schorsch3000/TrustIssue/README.md

# Trust Issue

A hardware TOTP vault for people who don't trust their computers.

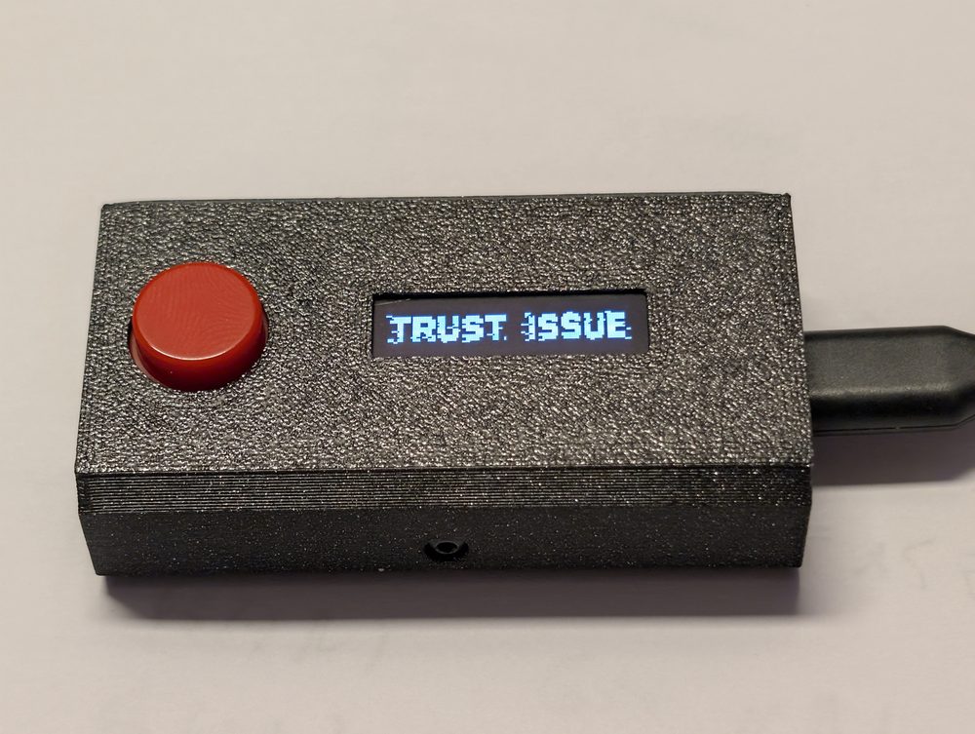
[picture p1: docs/_static/device/device-readme.jpg]
The finished device: a 3D printed case with a red button and the display, on a USB cable


The secrets live on a small device (an Arduino Nano with a 128x32 OLED and one button) and never
leave it. The host can add keys, list their names, and ask for a code, but every one of those
needs somebody to hold the button on the device while its display shows what is being done.
Malware on the laptop can neither export the secrets nor silently use them, and it cannot reflash
the device either: the bootloader only opens after a gesture on the button.

`wiring.md` shows how to wire the Nano, the display and the button; the 3D printed case is described in the documentation (`docs/hardware/case.md`, files in `Case/`).

`CLAUDE.md` holds the design decisions and the detailed state of the project.

## Why not a YubiKey?

If a service supports FIDO2/WebAuthn, use a YubiKey (or any security key) there: it is phishing-resistant, which a
TOTP code never is, and it is better engineered than this project. Trust Issue is for the many services that only
offer TOTP, and it differs from a YubiKey's OATH feature in a few ways:

- **You see what you approve.** The display shows the key name and the local date and time of the code, and a code
  needs a deliberate 1 to 2 second hold. A YubiKey has no display: the host decides which credential and which time
  to ask for, and a touch is a context-free tap that malware can time. Without a touch requirement set per
  credential, a compromised host can read codes without any gesture.
- **Open and auditable.** The firmware, the bootloader and the host tool are all here and under the GPL. Updates need
  a physical gesture and can be protected with a PIN; a YubiKey's firmware cannot be updated or inspected by its owner.
- **Cheap and replaceable.** An Arduino Nano and a small display cost a fraction of a YubiKey, and keys are not bound
  to a vendor's app (the host side is a small command line tool and menus).
- **What you give up.** A YubiKey is a certified secure element that resists physical attacks; an ATmega328P does not
  (see "Physical access" below). It also only does TOTP: no FIDO2, no smartcard or PGP functions. It holds fewer
  keys than a YubiKey 5's OATH application (20 here, 32 there, 64 on newer firmware). And it is a do-it-yourself build.

Both can be used together; they solve different parts of the problem.

## What is in here

| Path | What |
| --- | --- |
| `firmware/core` | the application: serial protocol, confirm screens, idle logo, autonomous wipe |
| `firmware/trustcore` | portable C++ core (SHA-1, HMAC, TOTP, Base32, EEPROM storage, protocol parser, time) with host tests in `firmware/test` |
| `firmware/bootloader`  | the button-gated bootloader (2 KB, from scratch) |
| `firmware/calibration` | tiny firmware to try out contrast, logo and font on the display |
| `firmware/rigisp` | the test rig: ArduinoISP plus a button finger, on a second Nano (see `tools/build/rig.py`) |
| `trustctl` | the host tool in Go: `list`, `token`, `add`, `del`, `tz`, `config`, `wipe`, `flash`, `calibrate`, `font extract`, `logo extract`, `daemon` |
| `trustctl/cmd/trustctl-import` | `trustctl-import`: imports a Google Authenticator export with a webcam (a local web page, see below) |
| `tools/user` | tools for people who use the device: `trustctl-menu`, `dummy-keys.html` (fake keys), `font2png.py`, `png2font.py`, `c64rom2font.py`, `final_lock.sh`, `onboard_usbtiny.sh` |
| `tools/build` | for building and testing the project: end-to-end tests (need the rig), `release.sh`, `embed_firmware.sh`, `embed_fonts.py`, `gen_params.py`, `flash.py` |

## Hardware

Arduino Nano (ATmega328P, 16 MHz), SSD1306 128x32 OLED on I2C (A4 SDA, A5 SCL, address 0x3C), a
push button from A3 to GND (A3 to A5, 5V and GND are all on the analog side of the Nano). For development a second Arduino (an Uno) acts as ISP programmer and as
the "finger": its D4 goes through 1 kOhm to the Nano's A3, its D10 to the Nano's RST, and D11 to D13
to the Nano's D11 to D13 (full table in `CLAUDE.md`).

## Setting up a device

1. **With a USBtinyISP programmer** one script does steps 1 and 3 at once: `tools/user/onboard_usbtiny.sh --yes` (chip erase, bootloader, the core firmware built into the repo, fuses, development lock bits; `--final-lock` for a finished device). Otherwise:
1. **Bootloader (once, over ISP).** Put the `ArduinoISP` example sketch on the Uno, then
   `tools/user/flash_bootloader.sh <uno port> --yes`. It builds the bootloader, sets the fuses and the
   development lock bits and verifies them. The burn starts with a chip erase, so the keys are gone, unless you add
   `--keep-eeprom`. `tools/user/unlock.sh <uno port> --yes` is the way back from the final lock bits
   (`final_lock.sh`): a chip erase that destroys flash and EEPROM, followed by `flash_bootloader.sh`.
1. **Host tool.** Download the archive for your system from the
   [releases](https://github.com/schorsch3000/TrustIssue/releases) (it holds `trustctl`, `trustctl-import` and the tools from `tools/user`; the
   `nightly` prerelease is the latest commit), or build it: `cd trustctl && go build -o bin/trustctl ./cmd/trustctl` (a static binary; Go 1.25+, which
   the module fetches by itself).
1. **Firmware.** `trustctl --device /dev/ttyUSB0 flash` (the core firmware is built into the `trustctl` binary;
   for development `flash FILE.hex` takes your own build, e.g. from `firmware/core/build.sh`). It tells you what to do on
   the device: hold the button while it resets, release when the display says so, wait for the bar,
   then tap, tap, press a third time and hold until the bar is full.
1. **Look and feel (optional).** Flash the built-in calibration firmware the same way
   (`trustctl flash calibration`), then
   `trustctl calibrate contrast full 0x20`, `calibrate contrast dim 0`, `calibrate logo Demo-Logos/trust_issue_01.png`,
   `calibrate font victoriabold8`, and `calibrate rotate on` or `calibrate invert on` to see a rotated or inverted display before setting it with `trustctl config set rotate=on` (the options like `--device` may stand before or after
   the command), and flash the core firmware again; the settings are
   patched in from `~/.config/trustctl/device.json`.
1. `trustctl config set logo=on` for the idle logo.
1. Optional: `trustctl flash --set-pin` adds an update PIN (see Security model). From then on every `flash` asks for it after the gesture (the device waits only 8 s for it: `flash --pin` asks first); `flash --clear-pin` removes it, `flash pin --set-pin` changes only the PIN.

Put `device = /dev/ttyUSB0` into `~/.config/trustctl/config` to leave out `--device`. `trustctl help-options` lists every
option with its `--argument`, environment variable and config file syntax, and the defaults.

Seven fonts are built into `trustctl` (`trustctl font list`; sources and licenses in `trustctl/internal/fonts/README.md`).
`trustctl calibrate font NAME` previews one on the calibration firmware and remembers it, `trustctl flash --font NAME`
patches one in and, once flashed, remembers it in the profile, and `trustctl font extract FILE.bin --name NAME` writes one out as a starting point.
A font file of your own works wherever a name does.

`tools/user/c64rom2font.py ROM [--set upper|lower] [--outdir DIR]` makes fonts from a C64 character ROM: a 4096 byte ROM gives
`NAME_upper.EXT` (capitals and graphics) and `NAME_lower.EXT` (lower case), a 2048 byte one gives `NAME_font.EXT`. Only the
ASCII range is taken (screen codes mapped to ASCII, a few characters like `\\` or `_` are approximated or blank). Then
`trustctl calibrate font NAME_lower.bin`. Mind the license of the ROM you convert; the original Commodore ROM is not ours to ship.

To start from what the device uses now, `trustctl font extract font.bin` writes the current font (the profile's, else the
built-in one) and `trustctl logo extract logo.png` writes the current logo as a 128x32 PNG (white = lit). The device itself
cannot be read back, so "current" means what `flash` would patch in; `--from firmware.hex` takes it from the parameter block
of a firmware file instead.

To edit a font as a picture, `tools/user/font2png.py font.bin sheet.png [--scale 8]` writes a sheet of 16 x 6 glyphs
(characters 32 to 127, 8x8 pixels each, white = lit) and `tools/user/png2font.py sheet.png font.bin [--scale 8]` turns the
edited sheet back into a font file (both need Pillow; the scale must match). Then `trustctl calibrate font font.bin`.

Tab completion (commands, options, key names asked from the device, file names for `flash` and `calibrate`):

```
source <(trustctl autocomplete)             # bash and sh-compatible shells; put it into ~/.bashrc
source <(trustctl autocomplete-zsh)         # zsh
trustctl autocomplete-fish | source         # fish
```

## Using it

```
trustctl list
trustctl add "GitHub"                      # asks for the secret (masked), then confirm on the device
trustctl add                               # paste an otpauth:// URI: it carries its own name (issuer:account)
pass show totp/github | trustctl add GitHub   # stdin is for automation only: never echo a secret (shell history, process list)
trustctl token git                         # prints the code once you hold the button 1-2 s
trustctl del GitHub
trustctl wipe                              # hold 5-6 s
```

The first command starts a small daemon that keeps the serial port open (so the device is not reset
by every command). `trustctl daemon stop` ends it. The device knows no clock: `token` sends the host's
time, and the display shows the resulting local date and time so you can see it is not for another
moment. Without a host, the keys can be wiped by a long hold at idle (`trustctl config set autowipe=on`
first).

To try it with fake keys, open `tools/user/dummy-keys.html` in a browser.

### Trying it without a device

`trustctl --device DUMMY` uses a simulated device instead of a serial port, so you can try the whole thing right after
building `trustctl`, with no hardware:

```
trustctl --device DUMMY add GitHub        # type or paste JBSWY3DPEHPK3PXP (any Base32 string) at the prompt
trustctl --device DUMMY add               # paste otpauth://totp/Example:bob?secret=JBSWY3DPEHPK3PXP&issuer=Example
trustctl --device DUMMY list
trustctl --device DUMMY token github      # a real TOTP code for that secret, compare it with any authenticator
trustctl --device DUMMY del GitHub
```

The dummy device follows the firmware's rules (names, secrets, parameters, the error messages) and prints the same
prompts as a real one, but accepts every confirmation without anybody holding a button. It lives in the background
daemon, so its keys stay from one command to the next, until the daemon stops: after the idle time (5 minutes by
default) or with `trustctl daemon stop`, which also gives you a fresh empty device. Nothing is ever stored on disk.
`DUMMY` also works as `TRUSTCTL_DEVICE=DUMMY` or `device = DUMMY` in the config file, which lets `trustctl-menu` and the
tab completion run against it. It cannot be used with `flash` or `calibrate`, and while the daemon holds the dummy
device a real one needs `trustctl daemon stop` first.

For one-shot experiments `trustctl --simulate` (or `TRUSTCTL_SIMULATE=1`) is simpler: a fresh, empty simulated device
inside the process for every command, nothing kept between commands (so it suits `add`, `tz` and `config`, but not a
round trip). `--device DUMMY --no-daemon` behaves the same way. `trustctl help-options` lists every option.

### A menu for Linux and BSD

`tools/user/trustctl-menu` is a small POSIX shell script: it lists the keys in a dmenu-like launcher, asks the
device for the code of the one you pick (hold the button) and hands it over.

```
trustctl-menu                                        # first launcher found: rofi, dmenu, wofi, bemenu, fuzzel
trustctl-menu chooser=rofi target=copy               # into the clipboard
trustctl-menu chooser=/bin/rofi target=copy clipboard=primary
trustctl-menu target=type delay=300 enter            # type it into the focused window (xdotool, or wtype on Wayland)
trustctl-menu sort                                   # list the keys sorted by name (default: the device's slot order)
trustctl-menu chooser=rofi -- -p token -theme-str 'window {width: 20%;}'   # after -- the launcher's own arguments
```

It needs `trustctl` in the `PATH` (with the device known to it, see above) and shows a notification if
`notify-send` exists, so you know the device is waiting for the button; the notice is closed again as soon as you have
confirmed, refused or the device timed out. Bind it to a key in your window manager.
The code never appears on a command line: it goes to `xdotool`, `wtype`, `xclip`, `xsel` or `wl-copy` through stdin.

### A tray icon for Windows

`tools/user/trustctl-tray/` is the Windows counterpart of `trustctl-menu`: a tray icon, an optional global hotkey, and a
dmenu-like picker. The hotkey or a click on the icon lists the keys with a text field that filters as you type (several
words must all match, names that start with the first word come first; Up, Down, Enter or a click choose, Esc closes).
The device then waits for the button, a balloon says so, and the code is typed into the window that was active before (an
optional Enter after it) or copied to the clipboard. The icon's menu has `Settings...`: the path of `trustctl.exe`, an
optional port such as `COM5`, the hotkey (click the field and press the keys), "Sort the keys by name" (otherwise they come in the device's slot order), typing or clipboard, and starting with Windows.
The settings are in `%APPDATA%\trustctl\tray.ini`; the code is never written anywhere or put on a command line.

Build it on Windows with `tools\user\trustctl-tray\build.cmd`: it uses the C# compiler that ships with Windows (.NET
Framework 4, no SDK to install) and writes `trustctl-tray.exe` next to the source. `tools/user/trustctl-tray/test.sh` compiles the
source with Mono on Linux and runs the tests of the filter, argument quoting, hotkey and settings code. It was tried on Windows by the user and works (hotkey, picker, button confirmation, typing the code).

### A menu bar icon for macOS

`tools/user/trustctl-menubar/` does the same on macOS: an icon in the menu bar (a click opens the picker, a right click
its menu with `Settings...`), an optional global hotkey, the same filtering picker, and the code typed into the app that
was active before (an optional Return after it) or copied to the clipboard (marked as concealed for clipboard managers).
The settings (path of `trustctl`, found by itself in the `PATH`, `/opt/homebrew/bin`, `/usr/local/bin`, `~/bin`,
`~/.local/bin` or `~/go/bin` when left empty; an optional port such as `/dev/cu.usbserial-110`; the hotkey; sorting;
typing or clipboard; start at login through a LaunchAgent) are in `~/Library/Application Support/trustctl/menubar.ini`.
Typing needs the Accessibility permission (System Settings > Privacy & Security > Accessibility).

Build it with `tools/user/trustctl-menubar/build.sh` (the Swift compiler of the Command Line Tools, no Xcode): it writes
`trustctl-menubar.app` (arm64 and x86_64, ad-hoc signed) next to the sources. `tools/user/trustctl-menubar/test.sh` runs
the tests of the list parsing, filter, hotkey, `trustctl` search and settings code.

### Importing from Google Authenticator

`trustctl-import` (`trustctl/cmd/trustctl-import`, its own small binary, `tools/build/build_trustctl.sh` builds it next to
`trustctl`) moves the accounts of a Google Authenticator export onto the device. Run it, and it opens a page in your browser
(a server on `127.0.0.1` that only that page can use, stopped with the Quit button or Ctrl-C). In Authenticator choose
"Transfer accounts", then "Export accounts", and show the QR code to the webcam; several codes are read one after the other.
The page then lists the accounts with a checkbox and an editable name each: untick what you do not need, correct the names
(the device's name rules are checked as you type), and press "Import selected". Every key is stored with `trustctl add`, so
every key still needs its button press on the device. Accounts the device cannot hold (HOTP, SHA256 or SHA512, secrets over
20 bytes) are listed greyed out with the reason.

```
trustctl-import                              # finds trustctl next to itself or in the PATH
trustctl-import --trustctl ./trustctl -- --device /dev/ttyUSB0   # after -- come options for trustctl
trustctl-import --no-browser                 # only print the address to open
```

The secrets stay in the `trustctl-import` process and the pipe to `trustctl`; the page only ever sees names. An export QR
code holds every secret in the clear: do this on a computer you trust, and close the Authenticator screen afterwards.

## Security model in short

- The main threat is a compromised host (malware on the laptop). Physical access is handled in layers, see
  "Physical access" below; only attacks on the chip itself are out of scope.
- Secrets can't be read back over serial. Adding, deleting, wiping, changing settings and every
  token need the button, with the name or value on the display.
- The bootloader only opens after a physical gesture and refuses to touch the EEPROM or itself.
  A held button at reset (the bait and switch) never opens it.
- When a device is finished, set the read-out lock bits with `tools/user/final_lock.sh` (undo: `tools/user/unlock.sh`, which erases everything). Until then the idle screen shows an inverted `UNLOCKED` and `trustctl hello` and `add` warn. The same goes for a missing update PIN (inverted `NO PIN` on the last row, `hello` and `add` warn).

### Physical access

Earlier versions treated anyone holding the device as an attacker who wins, and left it at that. That is no longer the
whole story. Whoever has the device for a while can do less than before, and what remains is spelled out here.

What stops an attacker who has the finished device (lock bits set) in their hands:

- **No reading over ISP.** With the lock bits (`final_lock.sh`, lock byte 0xCC) the programming header cannot read flash
  or EEPROM. The only thing it still allows is a chip erase, which destroys the keys too (the EEPROM is not preserved
  across a chip erase), so the keys cannot be taken that way.
- **No reflashing without the button gesture.** The bootloader opens only after holding the button through a reset,
  waiting for a bar, and a tap, tap, hold gesture. A press that the host did not ask for, a held button through a reset
  and a user mashing the button do not open it.
- **The update PIN.** Without a PIN, the gesture is all an attacker needs: two wires on the button pads and a
  microcontroller can do it, flash a firmware that dumps the EEPROM over serial, put the original firmware and the
  original EEPROM back, and nothing would show afterwards. With a PIN (`trustctl flash --set-pin`, 4 to 15 characters)
  the bootloader asks for it after the gesture. The device gives no sign whether a guess was right until a fixed wait
  of about 7 s has passed, and nothing can read the PIN back (the update mode has no flash read-back), so every guess
  costs the whole gate (about 8 s) plus that wait: a 4 digit PIN takes about 21 hours on average, 42 at worst; each
  additional digit multiplies that by ten. The PIN is only needed to flash; the device works without it.
- **Warnings.** A device without the final lock bits shows `UNLOCKED` on its idle screen, and `trustctl` warns.
- **Wiping.** `trustctl wipe` and, if you enable it, the autonomous wipe (a long hold at idle, no host needed) destroy the keys, so a
  device that must not be taken can be emptied. The keys come back from your offline backups.

What is not covered:

- **Long access.** Time is all the PIN buys. The USB port and the button are reachable by design, so an attacker needs
  no tools inside the case: a laptop on the USB port and a servo or solenoid on the button (or a wire to its pads) can
  try PINs unattended. A 4 digit PIN falls in about a day, a 5 digit one in about a week or two, a 6 digit one in months.
  Nothing on the device can notice or log this (no counter fits in the bootloader, and anything rewritable could be
  restored), and a tamper seal does not help while the port and button are outside the case. What helps: a PIN
  length matching how long the device could be out of your sight (a password manager that malware can reach is the
  cost of a longer one), and not leaving the device unattended for that long.
- **Attacks on the chip itself:** decapping, voltage or clock glitching, probing, cold boot. Anyone with the equipment for those
  wins against an ATmega328P; this is accepted.
- **A user who is talked into doing the gesture** on a screen the attacker induced (with a PIN, the attacker still needs it). The rule: never
  complete the update gesture unless you started an update. An unexpected update screen means do nothing; it times out
  into the application.
- **A compromised host and an evil maid together:** the PIN is typed on the host at an update, so a keylogger there sees it.
- **A stolen device** is not prevented, only made useless to read: you notice it is gone, rotate the passwords and reset the MFA of every account.
  A forgotten PIN is not fatal either (the device keeps working; recovery is an ISP chip erase, `tools/user/unlock.sh`, and re-adding the keys).

All of this only holds for a finished device: until the lock bits are set the programming header can read everything.

## License

Trust Issue is free software: you can redistribute it and modify it under the terms of the GNU General Public License,
version 3 or (at your option) any later version. See `LICENSE`. Copyright (C) 2026 Dirk Heilig.

The firmware and `trustctl` use third-party code and fonts under compatible licenses (LGPL 2.1+ Arduino core, BSD-licensed
avr-libc, U8g2 and Go libraries, CC0 and public domain fonts). Their notices, which binary releases must carry, are in
`THIRD_PARTY_LICENSES.md`.

## Tests

- `firmware/test/run.sh`: host tests of the portable core.
- `cd trustctl && go test ./...`: the host tool against a simulated device.
- `tools/build/smoke_dummy.py`: a built `trustctl` against its simulated device. CI (`.github/workflows`) runs all of this
  on every push to master, without the device.
- With the rig: `tools/build/core_test.py`, `tools/build/boot_test.py`, `tools/build/autowipe_test.py`,
  `tools/build/trustctl_e2e.py`, `tools/build/trustctl_flash_e2e.py` (the rig does the button gestures; `tools/build/rig.py` finds it, and `make_release.py` provisions the device through it and runs all of them, plus `locked_test.py` for the lock bits).

## Releases

`trustctl` and the firmware are released together: every `trustctl` binary carries the core and the calibration firmware
(`trustctl/internal/firmware/`, embedded with `go:embed`), so users flash with `trustctl flash` (core, the default) or
`trustctl flash calibration` and need no other file. `trustctl version` shows both versions. `tools/build/release.sh` runs
`tools/build/embed_firmware.sh` (builds both firmwares, copies the images, takes the version from `firmware/core/core.ino`) and
cross-compiles all platforms into `dist/` with `SHA256SUMS`. Commit the embedded images with the code; a test fails if the
embedded version differs from the source. Bump `VERSION` in `core.ino` for every firmware change that is released.

Every push to master runs the tests that need no device and updates the rolling prerelease `nightly` (archives with `trustctl` and `trustctl-import`
for all platforms, `tools/user`, the Windows tray tool and a firmware archive). A tag `vX.Y.Z` makes a full release with the
list of commit messages and the test report. The tag is made by `tools/build/make_release.py X.Y.Z --nano PORT --uno PORT`,
which runs every test including the rig tests first. See `docs/RELEASING.md`. Every archive has a build provenance
attestation: `gh attestation verify FILE --repo schorsch3000/TrustIssue`.
