schorsch3000/TrustIssue/docs/display/screens.md

# Screens of the device

Every screen the device can show, as the real firmware draws it (see {doc}`../development/display-images`
for how these pictures are made). The display is 128x32 pixels: four rows of sixteen characters.

(idle-screen)=
## The idle screen

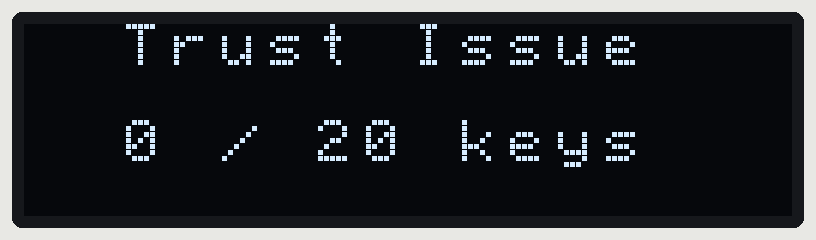
[picture p17: docs/_static/display/idle-empty.png]
Idle screen with no keys


A finished device with no keys.

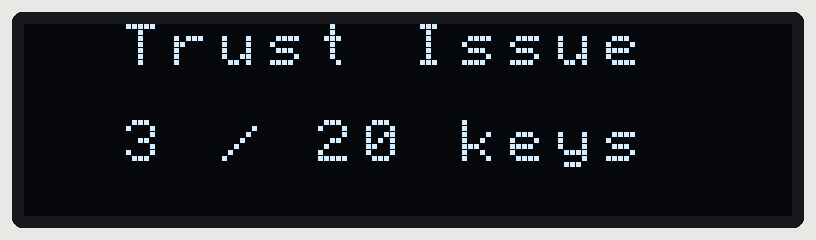
[picture p18: docs/_static/display/idle-keys.png]
Idle screen with three keys


With keys: how many of the 20 slots are used.

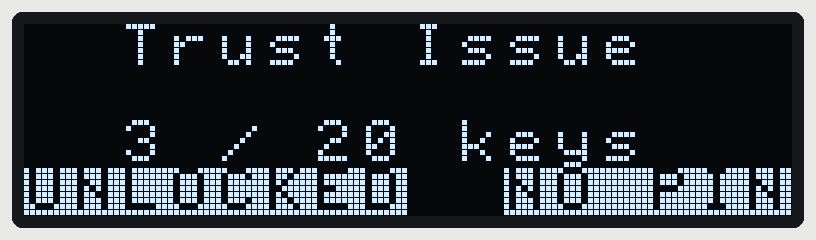
[picture p19: docs/_static/display/idle-development.png]
Idle screen of a development device


A device that is not finished: inverted `UNLOCKED` (the lock bits are not set, so the keys can be
read over the programming header) and `NO PIN` (no update PIN is set).

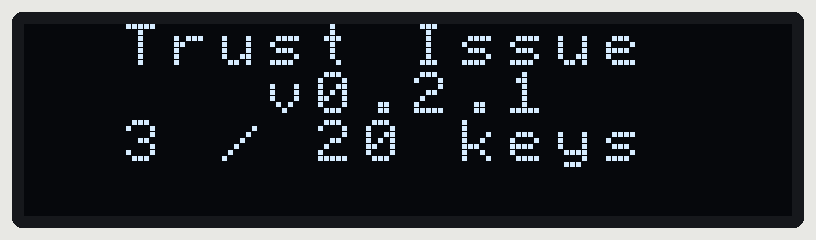
[picture p20: docs/_static/display/idle-version.png]
Idle screen with the version


With `trustctl config set show-version=on`: the firmware version on the second row.

The warnings are a reminder for the owner of the device, not a security boundary (a malicious
firmware could hide them, but flashing one needs the button gesture and the PIN). `trustctl hello` and
`trustctl add` print the same warnings on the computer. See {doc}`../security/physical-access`.

### Idle logo and sleep

After 10 seconds the display goes to sleep. With `trustctl config set logo=on` (and a logo in the
device's parameter block, see {doc}`../setup/calibration`) it first shows the logo, and shows it at
power-up too:

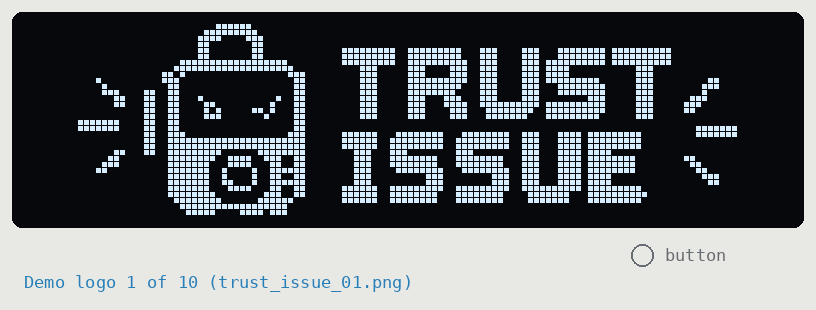
[picture p21: docs/_static/display/idle-logo.gif]
```{image} /_static/display/idle-logo.gif
:alt: Power-up: the logo for 5 seconds, the idle screen, then the logo at full contrast, dimmed, and finally the display turns off. The sequence repeats with each of the demo logos in turn.
```

Without the logo, the display simply turns off after the idle time. A button press wakes it:

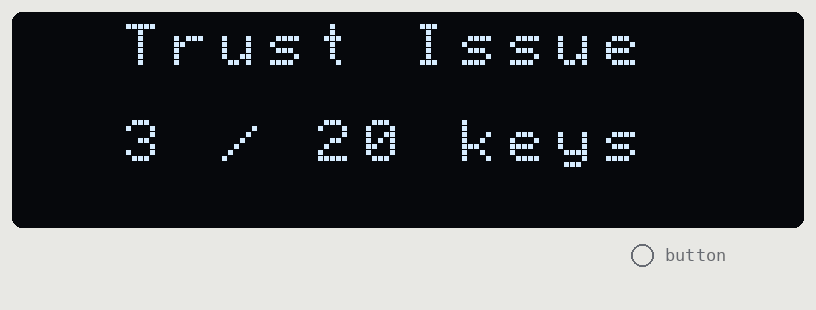
[picture p22: docs/_static/display/idle-sleep.gif]
```{image} /_static/display/idle-sleep.gif
:alt: The idle screen turns off after 10 seconds, a button press wakes it.
```

## Confirm screens

All of these wait for the button; hold 1 to 2 seconds (wipe: 5 to 6) and let go while the bar is a
checkerboard, see {doc}`../concepts`.

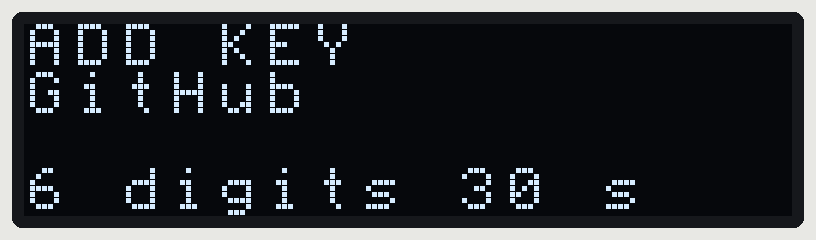
[picture p23: docs/_static/display/add-confirm.png]
Add key


`trustctl add`: the name and the parameters.

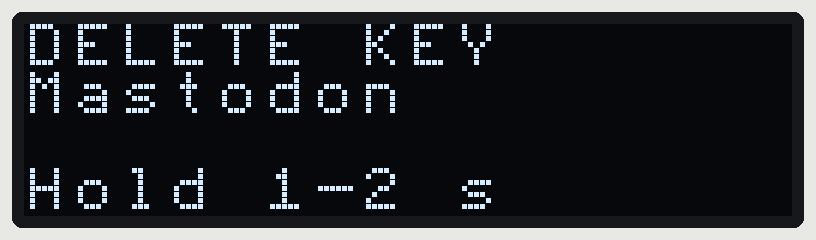
[picture p24: docs/_static/display/del-confirm.png]
Delete key


`trustctl del`.

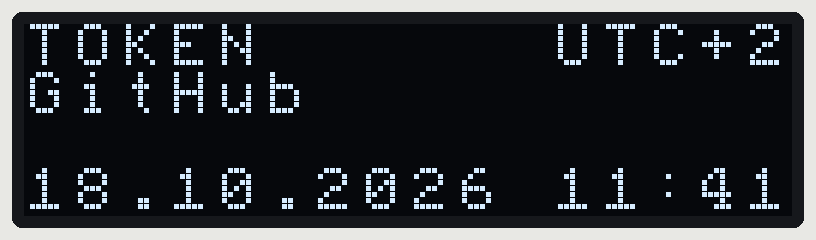
[picture p25: docs/_static/display/token-confirm.png]
Token request


`trustctl token`: the name, the timezone offset in the corner, and the local date and time the
code is for.

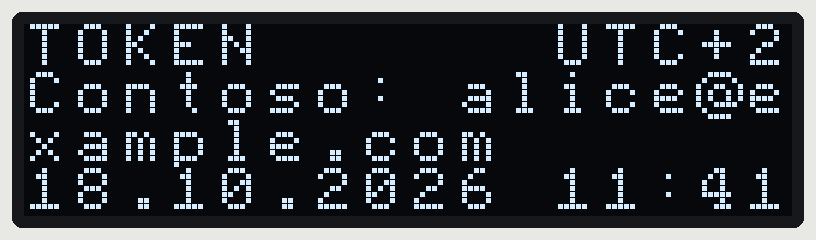
[picture p26: docs/_static/display/token-longname.png]
Token request with a long name


Names of up to 27 characters wrap over two lines; the whole name is always visible.

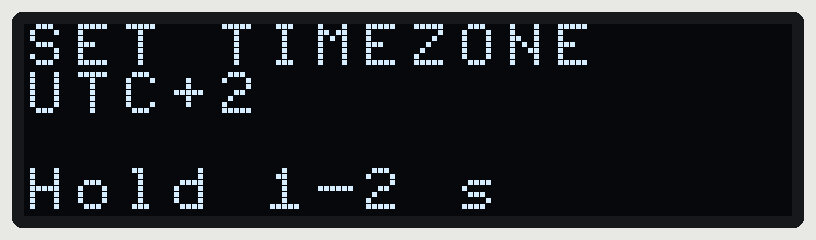
[picture p27: docs/_static/display/tz-confirm.png]
Set timezone


`trustctl tz set` or `tz sync`: the one place where you must know the correct offset.

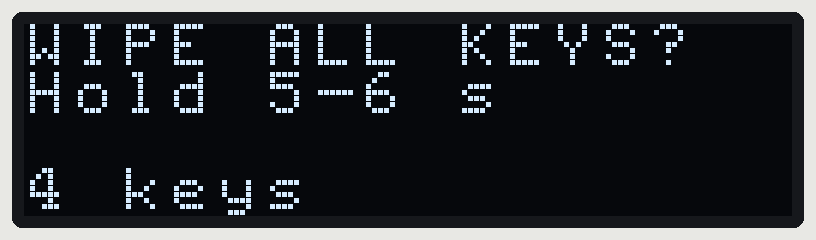
[picture p28: docs/_static/display/wipe-confirm.png]
Wipe


`trustctl wipe`: hold 5 to 6 seconds.

Settings

`trustctl config set`: all five settings, those this request changes in inverse.

## Results

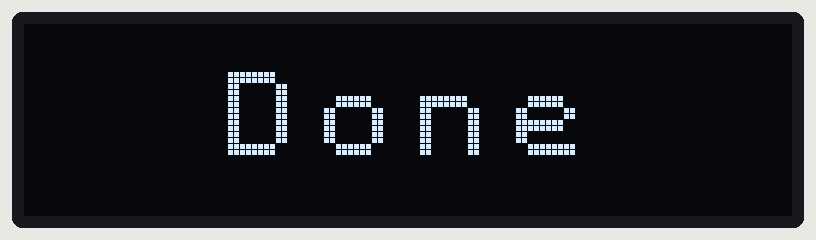
[picture p29: docs/_static/display/result-done.png]
Done


Accepted.

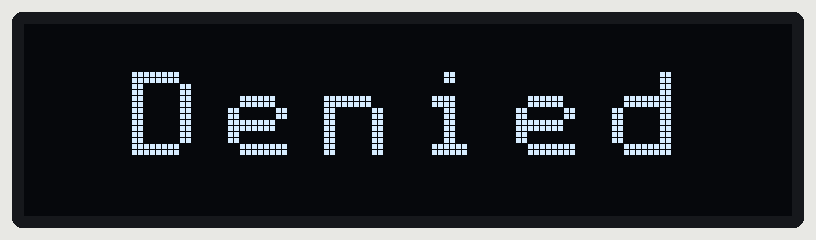
[picture p30: docs/_static/display/result-denied.png]
Denied


Let go too early (before 1 s, or a tap).

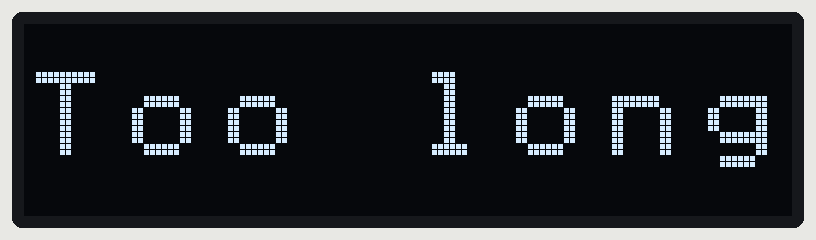
[picture p31: docs/_static/display/result-too-long.png]
Too long


Held past the end of the window: denied at once.

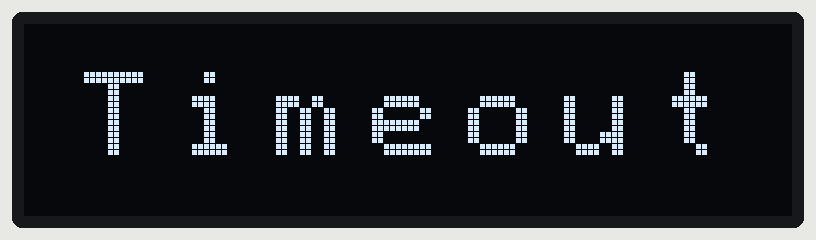
[picture p32: docs/_static/display/result-timeout.png]
Timeout


Nobody answered for 30 s.

After an accepted code request, `Done` is followed by the code in large digits for five seconds:

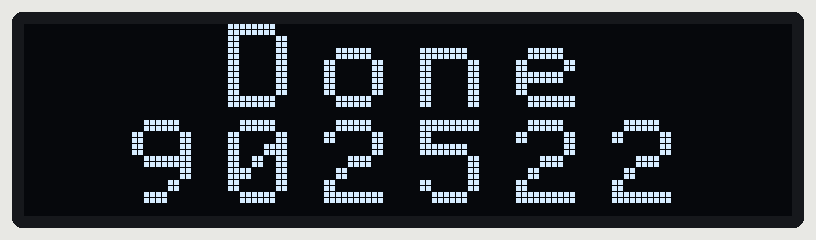
[picture p33: docs/_static/display/token-code.png]
```{image} /_static/display/token-code.png
:alt: The result screen of a code request: Done and the six digit code.
```

## Wiping without a computer

With `trustctl config set autowipe=on` the keys can be destroyed with the button alone (a power bank is
enough). Hold the button at idle: after 2 seconds a bar appears, and you let go between 10 and 11
seconds. Then a four second countdown (a press cancels), then the same gesture as the bootloader's:
tap, tap, press a third time and hold for 2 seconds. Any mistake starts the gesture over, and
after 20 seconds it is cancelled.

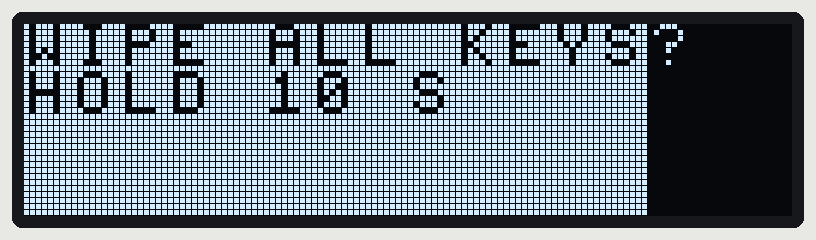
[picture p34: docs/_static/display/autowipe-hold.png]
Hold 10 s


The bar to the end of the 10 to 11 s window.

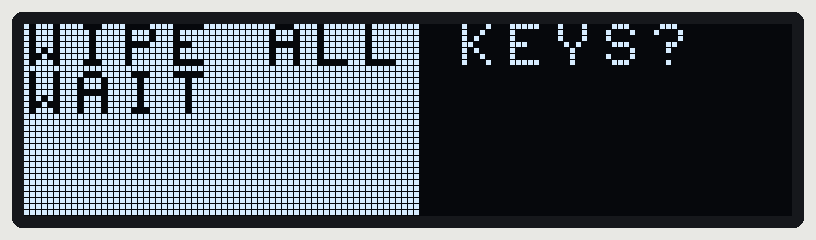
[picture p35: docs/_static/display/autowipe-countdown.png]
Countdown


A draining bar; any press cancels.

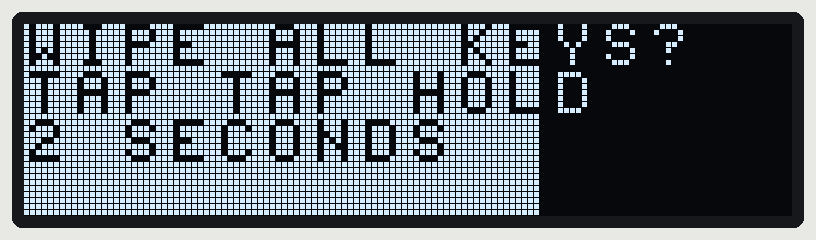
[picture p36: docs/_static/display/autowipe-gesture.png]
Gesture


A third of the bar per tap; the hold fills the rest.

```{image} /_static/display/autowipe.gif
:alt: The whole autonomous wipe: hold 10 seconds, countdown, tap, tap, hold, wiping.
```

## Bootloader screens

The bootloader draws its own screens when the button is held while the device resets. They are
described with the flashing procedure in {ref}`the-gate`.
