schorsch3000/TrustIssue/Case/body.stl

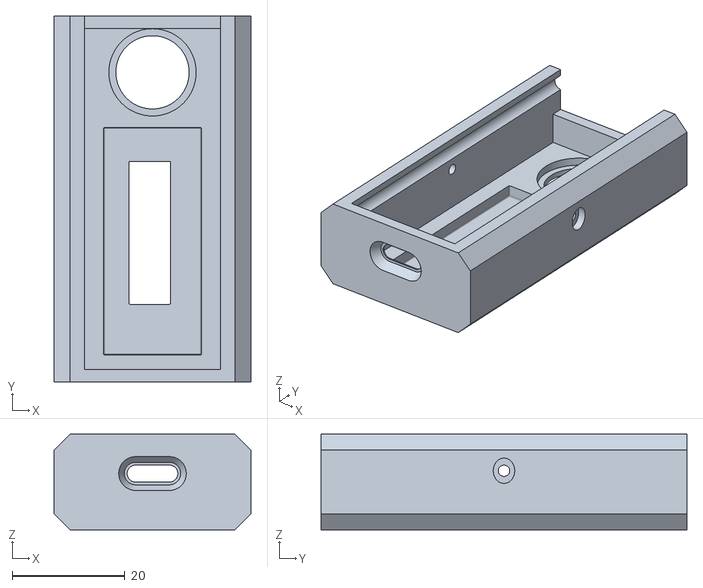
[picture p37: CAD file, 2026-10-18]
Case/body.stl
35.0 x 65.0 x 17.0
