schorsch3000/TrustIssue/Case/lid.stl

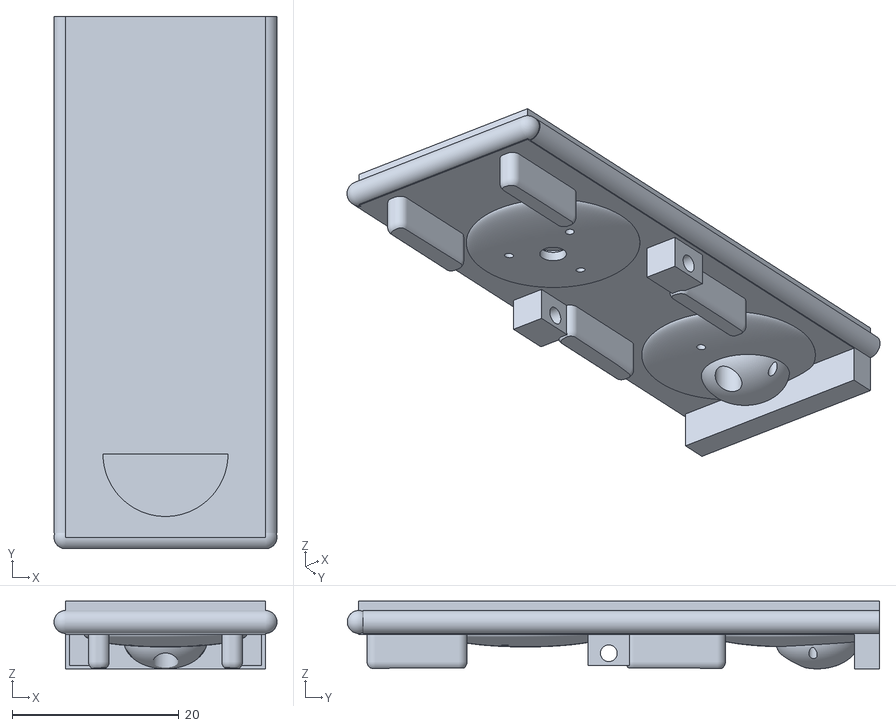
[picture p38: CAD file, 2026-10-18]
Case/lid.stl
26.8 x 63.9 x 8.12
