schorsch3000/TrustIssue/Case/mid.stl

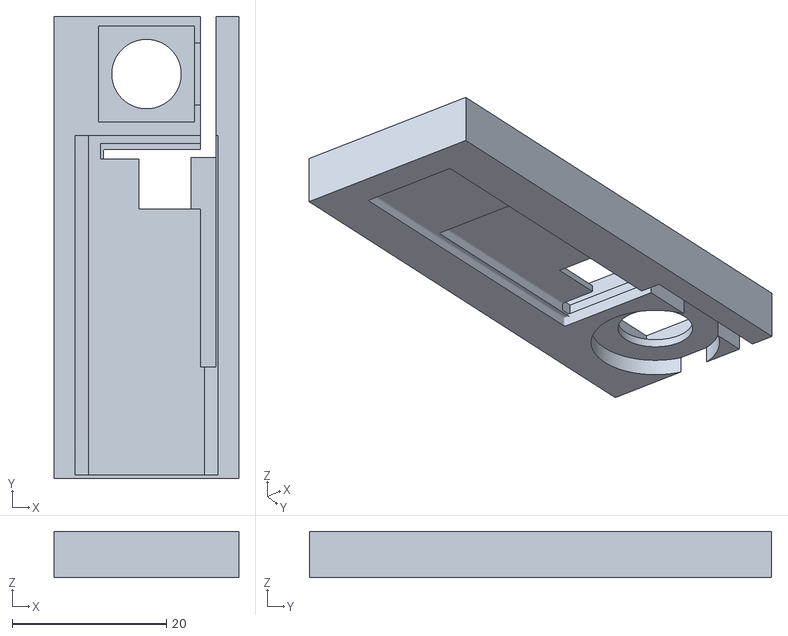
[picture p39: CAD file, 2026-10-18]
Case/mid.stl
24.0 x 60.0 x 6.00
