schorsch3000/TrustIssue/docs/hardware/wiring.md

# Wiring

```{image} /_static/wiring.svg
:alt: Wiring diagram: Nano 5V to display VCC, GND to display GND and the button, A5 to SCL, A4 to SDA, A3 to the button.
:align: center
```

The picture shows the connections (the drawing is schematic: it does not show the real pin order of
your display module, see below). The text that follows is the complete build description.

```{include} ../../wiring.md
:start-line: 1
```
