schorsch3000/TrustIssue/docs/test-reports/v0.2.1.md

# Test report v0.2.1

- Commit tested: `9ee721fe5f69ab828c9c2a928fa05adba3de7277`
- Firmware version: 0.2.1, `trustctl`: trustctl fw0.2.1-nightly-3-g9ee721f, built-in firmware 0.2.1
- Run: 2026-10-18 20:30 UTC on Linux aarch64 (6.18.50+rpt-rpi-v8)
- Tools: unknown; unknown; avr-gcc of the Arduino core; Python 3.13.5
- Where: *host* suites need no device and also run in CI on every push; *rig* suites ran on the real dev device (Arduino Nano, SSD1306 display, button pressed and chip programmed by the rig Nano, tools/build/rig.py) and cannot run in CI.

| Suite | Where | Result | Checks passed | Checks failed | Time |
| --- | --- | --- | --- | --- | --- |
| provision the device over ISP: chip erase, bootloader, firmware under test (rig.py provision) | rig | passed |  |  | 67 s |
| core firmware: protocol, button gesture, storage, time (core_test) | rig | passed | 47 |  | 50 s |
| autonomous wipe (autowipe_test) | rig | passed | 15 |  | 93 s |
| trustctl against the device (trustctl_e2e) | rig | passed | 19 |  | 28 s |
| bootloader gate and update PIN (boot_test --pin) | rig | passed | 23 |  | 194 s |
| trustctl flash and calibrate (trustctl_flash_e2e) | rig | passed | 24 |  | 82 s |
| lock bits and the unlocked indicator (locked_test) | rig | passed | 14 |  | 115 s |

**Only the rig suites were run here; the host suites ran in CI.**

## Not covered by any automated test

- The display, checked by eye on the dev device: text, the large result screens, the progress bar, rotation, inversion and the logo.
- `trustctl` on macOS and the BSDs (cross-compiled only), the zsh and fish completions, and the Windows tray tool's window (its helpers are tested).
- `onboard_usbtiny.sh` against a real USBtiny programmer (tested with a fake avrdude here). The lock bits and the unlocked indicator are tested on the rig (locked_test).

## Output

<details><summary>provision the device over ISP: chip erase, bootloader, firmware under test (rig.py provision): passed</summary>

```
chip found, lock byte 0xcf
burning the bootloader (chip erase first)...
avrdude: 1 byte of efuse verified

avrdude done.  Thank you.

avrdude done.  Thank you.

fuses: low 0xff high 0xda extended 0xfd, lock 0xcf
bootloader installed. Next: trustctl flash
device: /dev/ttyUSB1
```

</details>

<details><summary>core firmware: protocol, button gesture, storage, time (core_test): passed</summary>

```
PASS  HELLO
PASS  ADD accepted gets slot 0
PASS  LIST shows the key
PASS  case-insensitive duplicate, no prompt
PASS  bad name, no prompt
PASS  DEL unknown slot, no prompt
PASS  DEL (0x7F) is not allowed in a name
PASS  a name with punctuation and @ is accepted
PASS  LIST shows the punctuation name unchanged
PASS  and it can be deleted
PASS  TOKEN accepted: counter 1 (t=35)
PASS  TOKEN accepted: leading zero in the code
PASS  TOKEN tap is denied
PASS  TOKEN 0.9 s is denied
PASS  TOKEN 2.3 s is denied
PASS  request for the overshoot test
PASS  past the window: denied at the end of the window, not at the release
PASS  a new request while the button is still down is not denied by that old press
PASS  after letting go and pressing again it works
PASS  TOKEN 1.1 s is accepted
PASS  TOKEN 1.9 s is accepted
PASS  token uses request time plus elapsed time
PASS  second request is pending
PASS  other commands get ERR BUSY while pending
PASS  the pending request still completes
PASS  GETTZ default
PASS  SETTZ accepted
PASS  GETTZ after SETTZ
PASS  SETTZ denied keeps the value
PASS  GETTZ unchanged
PASS  GETCFG default
PASS  SETCFG accepted
PASS  GETCFG after SETCFG
PASS  SETCFG back to default
PASS  reserved config bit
PASS  unknown command
PASS  missing argument
PASS  DEL accepted
PASS  LIST empty after DEL
PASS  TOKEN on a deleted key
PASS  ADD for the wipe test
PASS  WIPE needs the long hold (1.5 s denied)
PASS  WIPE accepted at 5.5 s
PASS  no keys after WIPE
PASS  timezone survives WIPE
PASS  WIPE on an empty device needs no confirmation
PASS  restore timezone 0
ALL PASSED
```

</details>

<details><summary>autonomous wipe (autowipe_test): passed</summary>

```
PASS  the firmware says it has the autonomous wipe
PASS  start with no keys
PASS  add a key
PASS  add another key
PASS  switched off (the default): a 10.5 s hold does nothing
PASS  switch the autonomous wipe on
PASS  the flag is set
PASS  holds of 9 s, 12 s and 1.5 s do nothing
PASS  during the flow the device is busy
PASS  a press during the countdown cancels
PASS  wrong gestures wipe nothing: the flow still waits for the right one
PASS  the right gesture wipes all keys
PASS  the configuration survives the wipe
PASS  with no keys, the long hold starts nothing (the device answers)
PASS  switch it off again
ALL PASSED
```

</details>

<details><summary>trustctl against the device (trustctl_e2e): passed</summary>

```
PASS  list on an empty device
PASS  add confirms once and reports slot 0
PASS  a duplicate name is refused without a prompt
PASS  a bad name is refused before the device is bothered
PASS  list shows the key
PASS  tz shows the device offset
PASS  token: offset sync confirmed, then the code (matches the host's TOTP)
PASS  device and host offsets now agree
PASS  token again: one confirmation only
PASS  a tap denies: exit code 2, no code printed
PASS  an unknown key
PASS  config set and get
PASS  del confirms once
PASS  list is empty again
PASS  wipe with a normal hold is denied
PASS  wipe with a 5.5 s hold works
PASS  no keys after the wipe
PASS  the daemon is running and holds the device
PASS  daemon stop works
ALL PASSED
```

</details>

<details><summary>bootloader gate and update PIN (boot_test --pin): passed</summary>

```
-- normal operation
PASS  the application runs after a reset without the button
PASS  a host that resets the chip and speaks STK500 gets no answer
PASS  the application is still running afterwards
-- bait and switch: the button is held while the chip is reset
PASS  no update mode after a held reset, even after the release (gate times out)
PASS  the gate timed out into the application
-- gate mistakes
PASS  pressing during the countdown does not open the update mode
PASS  after a press in the countdown the device ends up in the application
PASS  tap, tap without the hold does not open it
PASS  tap, tap and a hold of 0.9 s does not open it
PASS  tap and a hold (one tap too few) does not open it
PASS  a long first press does not open it
-- the correct gesture, then what the update mode refuses
PASS  EEPROM write is refused (reply 1411)
PASS  writing the bootloader's own section is refused (reply 1411)
PASS  a page with a wrong checksum is refused (reply 1411)
PASS  READ_PAGE returns no page of flash data (166 bytes came back)
-- after all that
PASS  the device restarted into its application (the firmware was not damaged)
-- the update PIN
PASS  a PIN was written through the gate
PASS  an unanswered PIN prompt times out into the application
PASS  a wrong PIN starts the application instead
PASS  the application runs after a wrong PIN (trustctl hello)
PASS  with a PIN set HELLO has no nopin and trustctl does not warn
PASS  the right PIN opens the update mode, also only after the bar (7.0 s)
PASS  after removing it the gesture alone opens the update mode again
ALL PASSED
```

</details>

<details><summary>trustctl flash and calibrate (trustctl_flash_e2e): passed</summary>

```
-- flash the calibration firmware
PASS  flash calibration firmware through the gate
-- calibrate (look at the display)
PASS  contrast full
PASS  contrast dim
PASS  a contrast above 255 is refused
PASS  logo preview
PASS  font preview
PASS  font list
PASS  built-in font 5x8 on the display
PASS  built-in font artossans8 on the display
PASS  built-in font artosserif8 on the display
PASS  built-in font chroma48medium8 on the display
PASS  built-in font torussansbold8 on the display
PASS  built-in font victoriabold8 on the display
PASS  built-in font victoriamedium8 on the display
PASS  an unknown font name is refused
PASS  a file that is no font is refused
PASS  calibrate rotate on
PASS  calibrate rotate off
PASS  calibrate invert on
PASS  calibrate invert off
PASS  calibrate rotate maybe is refused
PASS  the profile remembers it all
-- flash the core firmware with the profile patched in
PASS  flash core firmware with the patch
PASS  the application runs after flashing
ALL PASSED
```

</details>

<details><summary>lock bits and the unlocked indicator (locked_test): passed</summary>

```
PASS  an open device says unlocked in HELLO
PASS  a device without an update PIN says nopin in HELLO
PASS  the lock byte reads 0xcf before
PASS  final_lock.sh sets the lock bits
PASS  the lock byte reads 0xcc after
PASS  a finished device no longer says unlocked
PASS  a finished device without a PIN still says nopin
PASS  trustctl hello prints no unlocked warning
PASS  trustctl hello warns about the missing PIN
PASS  ISP reads no flash content from a locked chip
PASS  the bootloader gate still opens on a locked chip and flashes the firmware
PASS  after a gate update the device is still locked and answers
PASS  unlock.sh erases the chip and the lock reads 0xff again
chip found, lock byte 0xff
burning the bootloader (chip erase first)...
avrdude: 1 byte of efuse verified

avrdude done.  Thank you.

avrdude done.  Thank you.

fuses: low 0xff high 0xda extended 0xfd, lock 0xcf
bootloader installed. Next: trustctl flash
PASS  provisioned again: the device is open and answers
ALL PASSED
```

</details>
