schorsch3000/TrustIssue/tools/gen_params.py

#!/usr/bin/env python3
"""Generates firmware/core/params_default.h: the device parameter block with its defaults.

The block sits at a fixed flash address (0x7000); `trustctl flash` patches the
font, the logo and the contrast values into the hex file before flashing.

  tools/gen_params.py firmware/fonts/victoriamedium8.bin firmware/core/params_default.h

Layout (all offsets in bytes from the start of the block):
  0x000  "TIPB"  magic
  0x004  version (1)
  0x005  flags: bit0 font valid, bit1 logo valid
  0x006  contrast for the full phase
  0x007  contrast for the dim phase
  0x008  reserved (8 bytes, 0xFF)
  0x010  font: 772 bytes, U8x8 format (4 byte header, 96 glyphs of 8 bytes, characters 32..127)
  0x314  logo: 512 bytes, 128x32, SSD1306 page layout (8 pixels per byte, LSB at the top)
  0x514  end
"""
import sys

BLOCK_SIZE = 0x514
font = open(sys.argv[1], "rb").read()
if len(font) != 772 or font[:4] != bytes([32, 127, 1, 1]):
    raise SystemExit("not a 96 glyph 8x8 U8x8 font (772 bytes, header 32 127 1 1)")
block = bytearray(b"\xff" * BLOCK_SIZE)
block[0:4] = b"TIPB"
block[4] = 1
block[5] = 0x01  # font valid, no logo
block[6] = 0x20  # contrast full
block[7] = 0x00  # contrast dim
block[0x10:0x10 + 772] = font
block[0x314:0x314 + 512] = bytes(512)
lines = []
for i in range(0, len(block), 16):
    lines.append("    " + ", ".join(f"0x{b:02X}" for b in block[i:i + 16]) + ",")
open(sys.argv[2], "w").write(
    "// Generated by tools/gen_params.py, do not edit. Defaults of the device parameter block.\n"
    "#include <stdint.h>\n"
    f"const uint8_t PARAMS[{BLOCK_SIZE}] __attribute__((section(\".paramblock\"), used)) = {{\n" + "\n".join(lines) + "\n};\n")
print(f"params block of {BLOCK_SIZE} bytes written")
