schorsch3000/TrustIssue/(commit log)

2026-10-15 Add Trust Issues firmware, button-gated bootloader and dev tooling
    A hardware TOTP vault on an Arduino Nano (ATmega328P) with an SSD1306
    128x32 display and one button.
    - firmware/trustcore: SHA-1, HMAC, TOTP, Base32, EEPROM storage with
    crash-safe slots and an interleaved wipe, protocol parser, local time.
    Host tests in firmware/test.
    - firmware/core: the application (serial protocol, confirm screens,
    progress bar, token from request time plus elapsed time).
    - firmware/bootloader: from-scratch bootloader that only opens its STK500
    update mode after a physical gesture (hold at reset, release, wait for
    the bar, tap, tap, hold). Flash only; EEPROM and its own section are
    refused.
    -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
    [boot.c, boot_test.py, calibration.ino, core.ino, core_selftest.ino, core_test.py, core_types.h, extract_u8x8_font.py]
2026-10-15 Add trustctl, the host CLI for the device
    A Go command line client for the Trust Issues serial protocol:
    list, token, add, del, tz, config, wipe and hello.
    - internal/protocol: protocol client (PENDING handling, typed errors),
    key name, Base32 secret and otpauth URI validation.
    - internal/sim: simulated device with the firmware's validation, so the
    client can be developed and tested without hardware (--simulate).
    - internal/serialdev: serial port handling with a banner handshake and a
    settle time, because opening the port can reset the device twice.
    - Secrets are read from stdin (hidden on a terminal), never from argv.
    token syncs the device's timezone offset to the host's first.
    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
    [trustctl_e2e.py]
2026-10-15 trustctl: keep DTR up between runs so read-only commands do not reset the device
    Opening a serial port raises DTR, which resets the Nano and lights its
    display. Clearing HUPCL before opening keeps DTR up after close, so only the
    first open after plugging in resets the device. The connection now asks
    HELLO instead of waiting for the banner and settles only if a reset
    happened, which brings a list from about 1.4 s to 0.15 s.
2026-10-15 trustctl: daemon, flash and calibrate; device parameter block in the firmware
    trustctl
    - daemon: the first command starts a background process that keeps the
    serial port open and proxies the line protocol over a Unix socket in
    XDG_RUNTIME_DIR. It caches LIST, GETTZ and GETCFG, answers ERR BUSY to a
    second client while a request waits for the button, and exits when told
    to, when idle, when the device disconnects or after a suspend.
    - flash: parses the hex, patches the device parameters, resets the device,
    waits for the bootloader gate and writes and verifies the pages
    (STK500v1 over serial, in Go, no avrdude needed).
    - calibrate: contrast, logo (PNG conversion) and font previews o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
    [calibration.ino, core.ino, flash.py, gen_params.py, trustctl_e2e.py, trustctl_flash_e2e.py]
2026-10-15 Progress bar: solid before the accept window, checkerboard inside it
    The bar spans 0 to the end of the window, so the start of the window had to
    be guessed. Now the bar is inverted up to the window start and a
    checkerboard from there on, which shows where releasing is accepted.
    The wipe's own progress stays a plain bar. trustctl_flash_e2e.py got a
    --flash-only mode.
    [core.ino, trustctl_flash_e2e.py]
2026-10-15 Autonomous wipe: wipe the keys with the button alone
    With the capability built in (AUTONOMOUS_WIPE, on by default in build.sh) and
    config bit 3 switched on, a hold of 10 to 11 s at idle starts a flow:
    a draining 4 s bar (a press aborts), then the bootloader's gesture (tap, tap,
    press and hold 2 s), then the wipe with the display as progress bar.
    Everything else is busy meanwhile; HELLO reports caps=autowipe.
    tools/autowipe_test.py checks it with the Uno rig.
2026-10-15 Show the logo for 5 seconds after power-up when the logo option is on
    The boot logo is a phase of the idle sequence (not a blocking delay), so
    serial commands keep working during it. A button press or a command that
    needs a confirmation cuts it short.
    [core.ino]
2026-10-15 Add tools/dummy-keys.html: dummy TOTP keys to try the dev device with
    A single HTML file (localStorage, no dependencies) that makes up keys,
    shows their live codes, offers the trustctl add command and checks a code
    typed from the device, so no real keys have to go onto the dev device.
2026-10-15 Large result screens, README, final lock script
    - The result screens (Done, Denied, Timeout, Wiped, Cancel) are drawn in
    large letters: the 8x8 font doubled to 16x16.
    - README.md: what it is, hardware, setup, use, security model, tests.
    - tools/final_lock.sh sets the final lock byte 0xCC after checking the
    fuses (not run on the dev device).
2026-10-15 trustctl add: take the name from an otpauth URI when none is given
    The label (Issuer:account, or the bare label when it already starts with the
    issuer) becomes the name. Characters the device cannot show become "-" and
    are reported; a name that is empty or too long is an error. A given NAME
    still wins.
2026-10-15 Fix: with autowipe on, the display went dark at once while the button was held
    serviceIdle() read the time first, then autoIdleHold() set lastActivity a few
    milliseconds later, so the unsigned difference now - lastActivity wrapped to
    about 49 days and the idle sequence put the display to sleep immediately.
    The difference is now signed and clamped at zero.
    [core.ino]
2026-10-15 Smooth progress bar between the taps of the gesture
    Bootloader and autonomous wipe: after a tap the bar runs to the next third in
    quick steps instead of jumping, and runs back to zero after a mistake.
    The bootloader got the room by dropping the "2 SECONDS" line (the filling
    bar shows how long to hold) and by merging two skip cases: 2038 of 2048 bytes.
    [boot.c, core.ino]
2026-10-15 trustctl autocomplete: completion code for bash/sh, zsh and fish
    trustctl autocomplete prints bash code (also autocomplete-bash and -sh),
    autocomplete-zsh and autocomplete-fish the others. They complete commands,
    options, key names (via the hidden __keys), sub-commands and file names, and
    are generated from one command table. The bash script is tested in real bash;
    zsh and fish could not be run here.
2026-10-15 tools/trustctl-menu: choose a key in rofi/dmenu and get its code
    A POSIX sh front end: the key names go into a dmenu-like launcher, the
    chosen key's token is asked from the device, and the code is printed, typed
    (xdotool, wtype) or copied (xclip, xsel, wl-copy), always through stdin.
    Parameters chooser, target, delay, enter, clipboard and -- for the launcher.
    Tested with fakes (test_trustctl_menu.sh).
2026-10-15 trustctl help-options: every option with its argument, environment variable and config syntax
    The names of the config keys and environment variables are shared constants
    now, and tests check that the text is complete, that the documented flags are
    accepted, that the config keys are read and that a flag beats the environment
    beats the config file. trustctl help prints the short usage.
2026-10-15 trustctl-menu: close the hold-the-button notice once the device was dealt with
    The notice is posted with an id and a 30 s expiry and closed as soon as
    trustctl token returns (accepted, refused or timed out), through gdbus or
    busctl, else by replacing it with a notice that vanishes at once.
2026-10-15 Overshooting the accept window denies at once, with a blink and "Too long"
    Past the end of the window (2 s, 6 s for wipe, 11 s for the autonomous wipe
    hold) the display blinks twice, shows "Too long" and the host gets ERR DENIED
    without waiting for the release. A press that is still going is ignored by a
    request that arrives meanwhile, so it cannot be denied by the old press.
    tools/core_test.py checks both on the rig.
    [core.ino, core_test.py, core_types.h]
2026-10-15 Result screens replace the progress bar directly, without blinking
    Too long (and every other result screen) is drawn tile by tile over the
    bar in one pass of about 20 ms instead of: bar off, blank screen, blink,
    word. The overshoot is denied at 2.1 s instead of 2.5 s.
    [core.ino]
2026-10-15 trustctl: global options may follow the command; clearer calibrate error
    trustctl calibrate --device PATH logo x.png took --device for an argument of
    calibrate. The global options are now taken out of the arguments wherever they
    stand. calibrate says how to build and flash the calibration firmware when it
    finds the core firmware on the device.
2026-10-15 trustctl: font extract and logo extract write the current font and logo to a file
2026-10-15 trustctl: built-in core and calibration firmware, flash without files; release script
2026-10-15 completion: flash offers core and calibration (file completion no longer discards them)
2026-10-15 core: the settings confirm screen inverts the flags that change; fix cut-off Wipe label
    [core.ino]
2026-10-15 Clean up: remove the superseded i2c_scan sketch and calib.py, replace the stale status notes
    [core.ino]
2026-10-15 Clean up: remove button_test, rig.py and the root logo.png; examples use Demo-Logos
2026-10-15 core: show NOT LOCKED on the idle screen and in HELLO when the lock bits and fuses are not final; trustctl warns
2026-10-15 flash_bootloader.sh: print the usage instead of failing on a missing argument
2026-10-16 bootloader: optional update PIN, page checksum and in-place verify instead of flash read-back
    After the button gesture the bootloader asks for an update PIN (last application page, blank = none) and decides only after a 7 s bar, so a guess costs the whole gate plus that wait. Flash read-back is gone (the PIN lives in flash); every page carries a sum byte and is compared with the RAM buffer after writing. trustctl flash: --set-pin, --clear-pin, flash pin, PIN prompt, page retry. Not yet run on the device: the new bootloader still has to be burned.
    [boot.c]
2026-10-16 bootloader PIN: fix the prompt loop and the PIN line timing found on the device, wrong PIN detected by silence; tests and docs
    Tested on the dev device: boot_test --pin, trustctl_flash_e2e (full and --pin-only), core_test, trustctl_e2e, autowipe_test. core_test waits for the previous result screen before the overshoot test.
    [boot.c]
2026-10-16 Key names: any printable ASCII (0x20-0x7E), firmware 0.1.1
    Names are stored as 8-bit bytes; the narrow set was only a validation rule. Firmware, trustctl, simulator and dummy-keys.html accept the whole range, otpauth labels keep @ and punctuation, bash completion no longer splits or globs names. Tests updated and extended; core firmware 0.1.1 embedded. Not yet run on the device.
    [core.ino, tc_storage.cpp, tc_storage.h]
2026-10-16 Bootloader: the PIN prompt times out after 8 s; flash --pin asks first; tests
    An unanswered PIN prompt waited for ever (found on the device). The prompt loop no longer resets the watchdog, the PIN screen stays during the bar (2040 of 2048 bytes). trustctl flash --pin asks for the PIN before the gesture. boot_test --pin checks the timeout and uses trustctl hello after a wrong PIN; trustctl_e2e uses a control character as the bad name; flash.py closes its port on errors.
    [boot.c]
2026-10-16 Button moves from D2 to A3 (bootloader, core 0.1.2, rig wiring, docs)
    All the wires of the production board are then on the analog side of the Nano (A3 button, A4 SDA, A5 SCL, 5V, GND). A6 and A7 are analog-only and cannot read a button. Tested on the dev device: core_test, autowipe_test, trustctl_e2e, boot_test --pin.
2026-10-16 tools/user: onboard_usbtiny.sh (bootloader, firmware, fuses over a USBtinyISP); final_lock.sh takes ISP_ARGS
    Tested with a fake avrdude (tools/build/test_onboard_usbtiny.sh), not yet with real hardware.
2026-10-16 wiring.md: wiring diagram for the end user (display and button on the analog side, button on A3)
2026-10-16 trustctl calibrate rotate|invert; decide timings and large alert screens; docs: user ran onboard and final lock on real hardware
2026-10-16 trustctl-tray: deliver the code (UI thread hand-over was broken), DPI scaling and wrapped hints in settings, Enter/delay under Type
2026-10-16 core 0.1.3: idle screen shows used / capacity keys (6 / 20 keys)
2026-10-17 License: GPL-3.0-or-later, third-party notices; calibration firmware drops the fonts that may not be redistributed
2026-10-17 README: YubiKey key capacity
2026-10-17 trustctl --device DUMMY: simulated device behind the daemon, keeps its keys between commands; trustctl-menu ignores stderr notices
2026-10-17 Third-party licenses: Demo-Logos and Case notes, table formatting; ignore resume
2026-10-17 Firmware 0.1.4: build with --clean so the 128 byte serial buffer is really built in (a cached Arduino core had hidden it)
2026-10-17 make_release.py: the default device config has the logo off
2026-10-17 128x64 displays: top half only. Display height in the device parameter block (patched by trustctl flash), calibrate display 128x64, bootloader and core send it; firmware 0.1.5, calibration 0.3
2026-10-17 Revert "128x64 displays: top half only. Display height in the device parameter block (patched by trustctl flash), calibrate display 128x64, bootloader and core send it; firmware 0.1.5, calibration 0.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
    This reverts commit a04f61e2fae8daaa83be9fe8b350fb2f5542afbb.
    [boot.c, calibration.ino, core.ino]
2026-10-17 Rig: one Nano with ArduinoISP and the button finger (firmware/rigisp), rig.py finds the rig and device and provisions over ISP, locked_test, make_release.py without ports plus timeouts and --dry-run;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
    [rigisp.ino]
2026-10-18 Rig CI: the Pi pulls the nightly of every master commit and tests it (rig_ci.py, systemd timer), make_release.py --rig-only/--trustctl/--core/--bootloader
2026-10-18 flash.py: with the rig, try the whole gate again when the device does not answer at all (up to 3 times, announced), the Pi missed the gesture once
2026-10-18 Releases tag the commit the rig machine tested: make_release.py --report-host copies the Pi's report, release.yml requires device-tests: success and links the report
2026-10-18 rig_ci: rig-power on only while testing and off in every case (also SIGTERM, stale marker), one run at a time via a lock in python, test_rig_ci.py
2026-10-18 rig-ci.timer: OnCalendar every 5 minutes instead of OnUnitInactiveSec, which stopped firing after a daemon-reload
2026-10-18 rig_ci: the Pi verifies the build attestation of its downloads before it powers the rig
2026-10-18 Preflight: find a current gh (TRUSTISSUE_GH, ~/.local/bin/gh, PATH) and report one without 'attestation' with the fix; Debian's 2.46 is too old
2026-10-18 Version 0.1.5: trustctl resets the device with RTS as well (boards whose reset hangs on RTS); firmware code unchanged
    [core.ino]
2026-10-18 Test report for 0.1.5 (device tests on the rig, commit 1426d34)
2026-10-18 Idle screen, HELLO and trustctl warn when no update PIN is set
    The core firmware reads the PIN page (0x7780): a blank first byte shows an
    inverted NO PIN on the last idle row and adds ' nopin' to HELLO and the banner
    (before ' unlocked'). NOT LOCKED moves to the top row. trustctl hello and add
    print a warning for nopin as well (warnAboutDevice). locked_test.py checks for
    the absence of the unlocked warning only, since a finished rig device has no PIN.
    Embedded core.hex rebuilt; version unchanged.
    [core.ino]
2026-10-18 Config flag show-version (bit 4): the idle title shows the firmware version
    With the flag on, 'Trust Issues' becomes 'TrustIssue 0.1.5' (exactly 16 columns;
    'Trust Issue v0.1.5' would not fit). The SETCFG confirm shows it on the first
    row (SETTINGS Ver:off). trustctl config get/set, completions and help-options
    know it; the protocol mask is 0x1F. Embedded core.hex rebuilt, version unchanged.
    [core.ino, tc_protocol.h, tc_storage.h]
2026-10-18 trustctl-import: import a Google Authenticator export with a webcam
    A separate static Go binary (not part of trustctl). It serves a page on
    127.0.0.1 (random port and token, Host/Origin checks, strict CSP) and opens the
    browser, which shows the camera and reads the QR codes (BarcodeDetector, else
    the embedded jsQR 1.4.0, Apache 2.0). The Go side decodes the export, keeps the
    secrets and stores each ticked account with 'trustctl add NAME' (URI on stdin).
    Names are editable and validated with the device's rules; the page follows the
    browser's light/dark setting. build_trustctl.sh builds it too.
2026-10-18 Idle screen layout: centered name, version line (show-version), key count, and a warning row
    Row 0 Trust Issues, row 1 v0.1.5 (only with show-version, else empty, so a version
    with two digit parts cannot overflow), row 2 n / m keys, row 3 inverted UNLOCKED
    (columns 0-7) and NO PIN (columns 10-15). Replaces the TrustIssue 0.1.5 title.
    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
    [core.ino]
2026-10-18 Tests: nopin and unlocked in HELLO and the trustctl warnings (simulated device, rig locked_test, boot_test --pin)
2026-10-18 Version 0.2.0: idle screen layout with NO PIN and UNLOCKED, nopin in HELLO, show-version setting; trustctl-import
2026-10-18 Test report for 0.2.0 (device tests on the rig, commit 2765b2b)
2026-10-18 Host simulation of the core firmware and the bootloader, and display pictures made from it
    firmware/hostsim builds core.ino and boot.c unchanged (bootloader: two asm lines replaced) against mock hardware;
    tools/docs/gen_display_images.py drives them with scripted serial and button input and renders PNG/GIF.
    [bootsim.cpp]
2026-10-18 Documentation for Read the Docs (Sphinx, MyST, furo)
    Setup, concepts, screens, trustctl reference, protocol, tools, security, troubleshooting, development.
    CI checks the display pictures are current and that Sphinx builds without warnings.
2026-10-18 Docs: checkerboard target zone picture and notes, PIN guessing tables for digits and passwords, GitHub link
2026-10-18 Case: printed parts, photos, case page; device photo in the README
    [body.stl, lid.stl, mid.stl]
2026-10-18 CLAUDE.md: record the rejected unlock-PIN idea
2026-10-18 Name is Trust Issue (singular) everywhere, on the display too: firmware 0.2.1
    Idle and calibration screens, docs, README, comments and messages; homepage gets 'Who it is for' and 'What you get'.
    Embedded firmware images and display pictures regenerated.
    [boot.c, c64rom2font.py, calibration.ino, core.ino, font2png.py, png2font.py, rigisp.ino]
2026-10-18 Test report for 0.2.1 (device tests on the rig, commit 9ee721f)
2026-10-18 Docs: favicon (the device seen from above)
2026-10-18 Docs: switch to sphinx_rtd_theme
2026-10-18 Display pictures: off-gray background with a dark display frame
2026-10-18 Display pictures: held button in red, like the real one
2026-10-18 trustctl-import: tested by the author with a real webcam, export and device
